bitkeeper/dddac1794build/powercontroller/README.MD

* attiny85 - software sketch for the attiny85
* design - initial design of the soft power off module
* pcb - scheme and pcb design for actual use
