bitkeeper/dddac1794build/powercontroller/design/tinkercad - pi poweroff switch.png

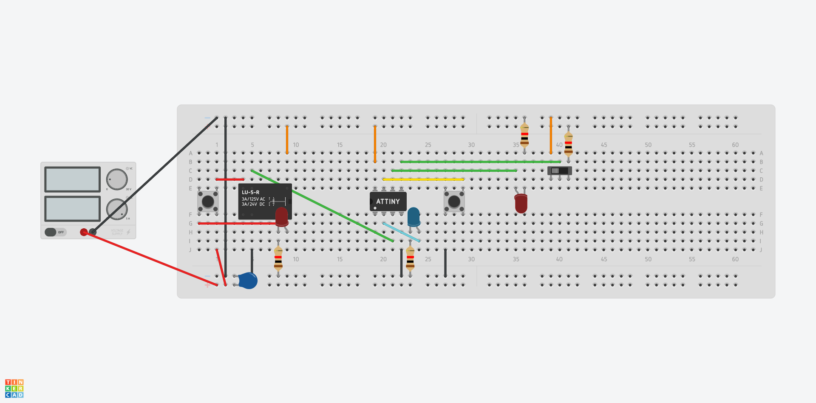
powercontroller/design/tinkercad - pi poweroff switch.png
