bitkeeper/dddac1794build/powercontroller/design/tinycad power switch.png

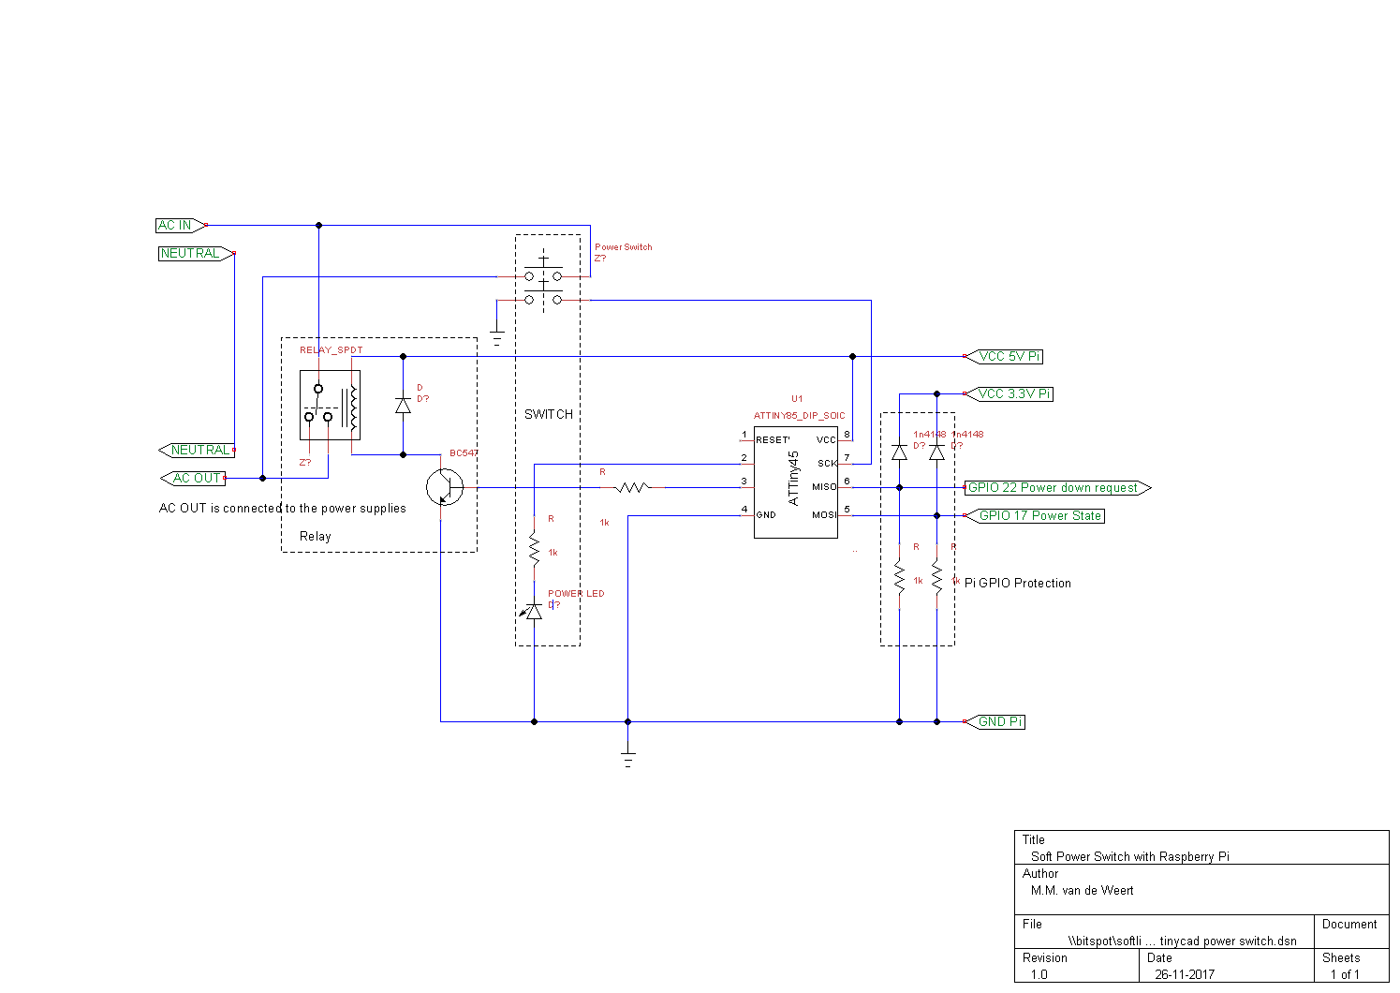
powercontroller/design/tinycad power switch.png
