bitkeeper/dddac1794build/raspberrypi/software/tweaks/moode_mpd_tweaks/moode_mpd_tweaks_config.png

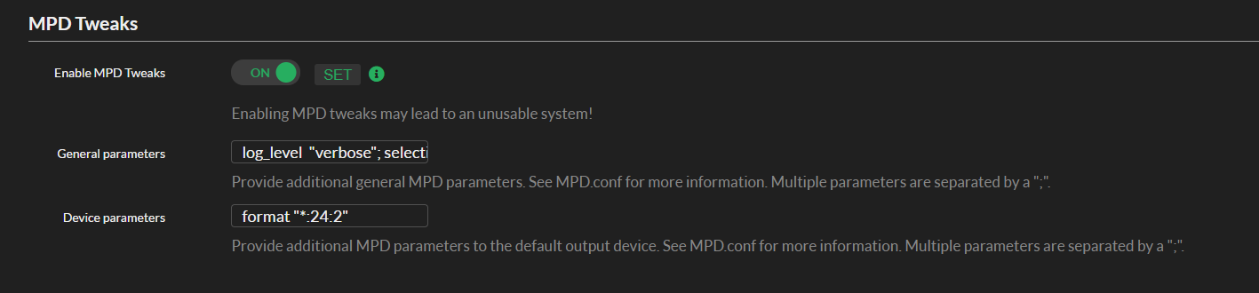
raspberrypi/software/tweaks/moode_mpd_tweaks/moode_mpd_tweaks_config.png
