bitkeeper/dddac1794build/system/partlist.ods

nr | description | subsystem | Supplier | count | price | total | Shipping
1 | DDDAC 1794 blue mainboard | dac | Audiocreative | 1 | € 165,00 | € 165,00 | € 0,00
2 | DDDAC 1794 DAC board | dac | Audiocreative | 3 | € 159,00 | € 477,00 | € 0,00
3 | DDDAC 12V PS | dac | Audiocreative | 1 | € 94,00 | € 94,00 | € 0,00
5 | DIYINHK Ultra Low Noise PS | streamer | Diyinhk | 1 | € 41,82 | € 41,82 | € 9,08
6 | Block RDK 30VA/2x6V | streamer | Conrad | 1 | € 19,64 | € 19,64 | € 0,00
7 | Raspberry 3 | streamer | SOSsolutions | 1 | € 36,95 | € 36,95 | € 0,00
8 | SD Card 8 GB | streamer | SOSsolutions | 1 | € 7,95 | € 7,95 | € 0,00
9 | Hifiberry Digi+ Pro | streamer | SOSsolutions | 0 | € 42,95 | € 0,00 | € 0,00
10 | AC Main C14 Chassis part | case | Conrad | 1 | € 5,25 | € 5,25 | € 0,00
11 | Fuse 20mm | case | Conrad | 1 | € 1,20 | € 1,20 | € 0,00
12 | Torx147 Optical SPDIF Receiver 192k | case | Diyinhk | 1 | € 3,35 | € 3,35 | € 9,08 | N.A. due combinated order
13 | CinchConnector Rean AV NYS367-9 | case | Conrad | 1 | € 4,36 | € 4,36 | € 0,00
14 | CinchConnector Rean AV NYS367-2 | case | Conrad | 1 | € 4,36 | € 4,36 | € 0,00
15 | CinchConnector Rean AV NYS367-4 | case | Conrad | 3 | € 4,36 | € 13,08 | € 0,00
16 | Cinch-connector internal | case | Conrad | 1 | € 1,48 | € 1,48 | € 0,00
17 | OLED Display 1.3" I2C | case | Diymall by ebay | 1 | € 8,51 | € 8,51 | € 0,00
18 | Galaxy Maggiorato GX388 330 x 280mm x 2HE 10mm front panel SILVER | case | Modus | 1 | € 53,00 | € 53,00 | € 13,00
19 | Base Galaxy GX345/348/385/388 | case | Modus | 1 | € 8,00 | € 8,00 | € 13,00 | N.A. due combinated order
20 | Case feets | case | Modus | 4 | € 3,50 | € 14,00 | € 13,00 | N.A. due combinated order
21 | Frontplate Job | case | Schaeffer | 1 | € 58,89 | € 58,89 | € 19,50
22 | Backplate Jobs | case | Schaeffer | 1 | € 42,38 | € 42,38 | € 19,50 | N.A. due combinated order
23 | Relais board arduino 1x relais (active high) | case | DX | 1 | € 2,30 | € 2,30 | € 0,00
24 | Relais board arduino 2x relais (active low) | case | DX | 1 | € 4,00 | € 4,00 | € 0,00
25 | Attiny85 | case | ? | 1 | € 2,30 | € 2,30 | € 2,60
26 | Switch TRU COMPONENTS LAS1-AGQ-22E, BL | case | Conrad | 2 | € 19,82 | € 39,64 | € 0,00
27 | Allo Isolator | streamer | SOSsolutions | 0 | € 60,95 | € 0,00 | € 0,00
28 | Cinemags CMLI-600/600 set | dac | Audiocreative* | 1 | € 249,00 | € 249,00 | € 0,00
29 | PiFace GPIO Shim | streamer | Kiwi Electronics | 1 | € 5,95 | € 5,95 | € 2,50
30 | FifoPi Q3 | reclocker | Audiophonics | 1 | € 159,00 | € 159,00 | € 8,50
31 | U.FL coax cable 6" | reclocker | Audiophonics | 3 | € 5,50 | € 16,50 | € 8,50 | N.A. due combinated order
32 | Custom print for power distribution | case | OSHPark | 1 | € 16,20 | € 16,20 | € 0,00
33 | Omron G3MB-202P | case |  | 1 | € 2,95 | € 2,95 | € 3,95
34 | PCB Screw Terminal | case |  | 5 | € 0,45 | € 2,25 | € 3,95 | N.A. due combinated order
 |  |  |  |  | parts | € 1560,31
 |  |  |  |  | shipping | € 59,13
 |  |  |  |  | total cost | € 1.619,44
