bitkeeper/dddac1794build/case/hifi2000_galaxy/preview/backplate.pdf

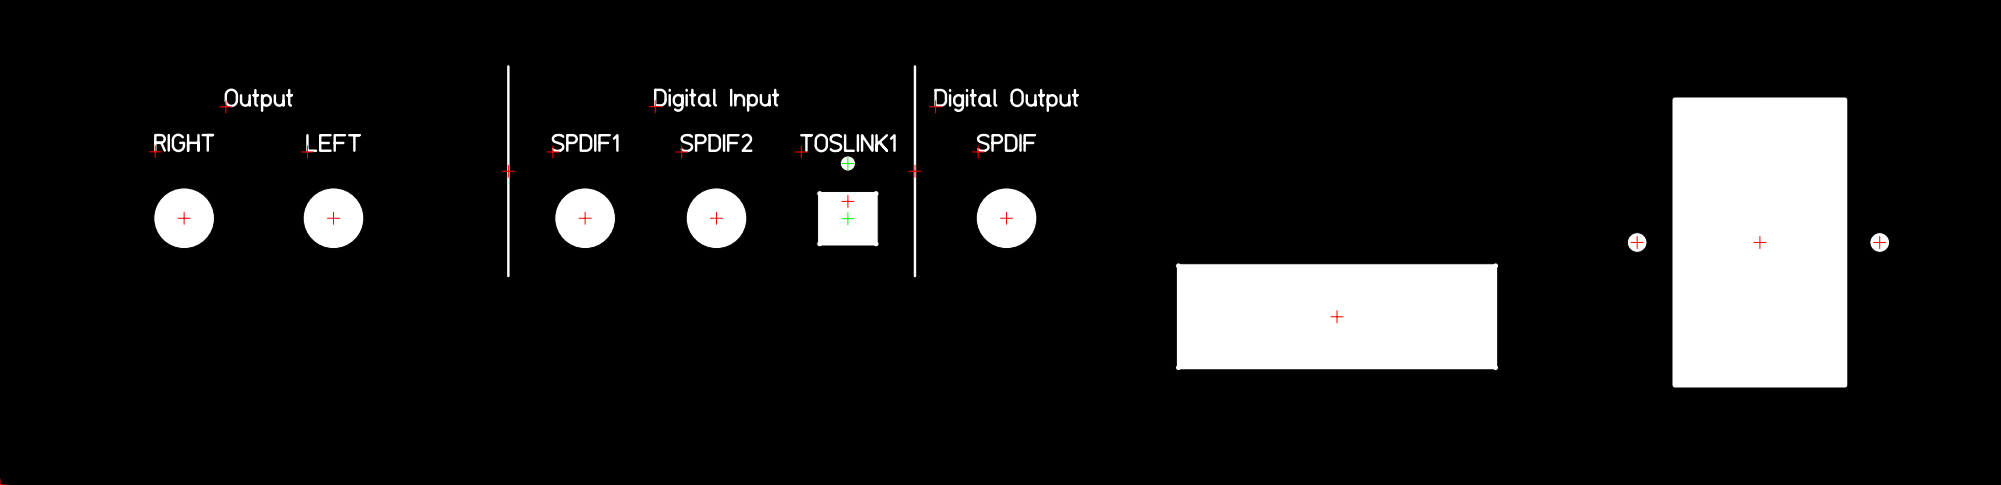
[picture p4: page 1]
