bitkeeper/dddac1794build/case/hifi2000_galaxy/preview/frontplate.pdf

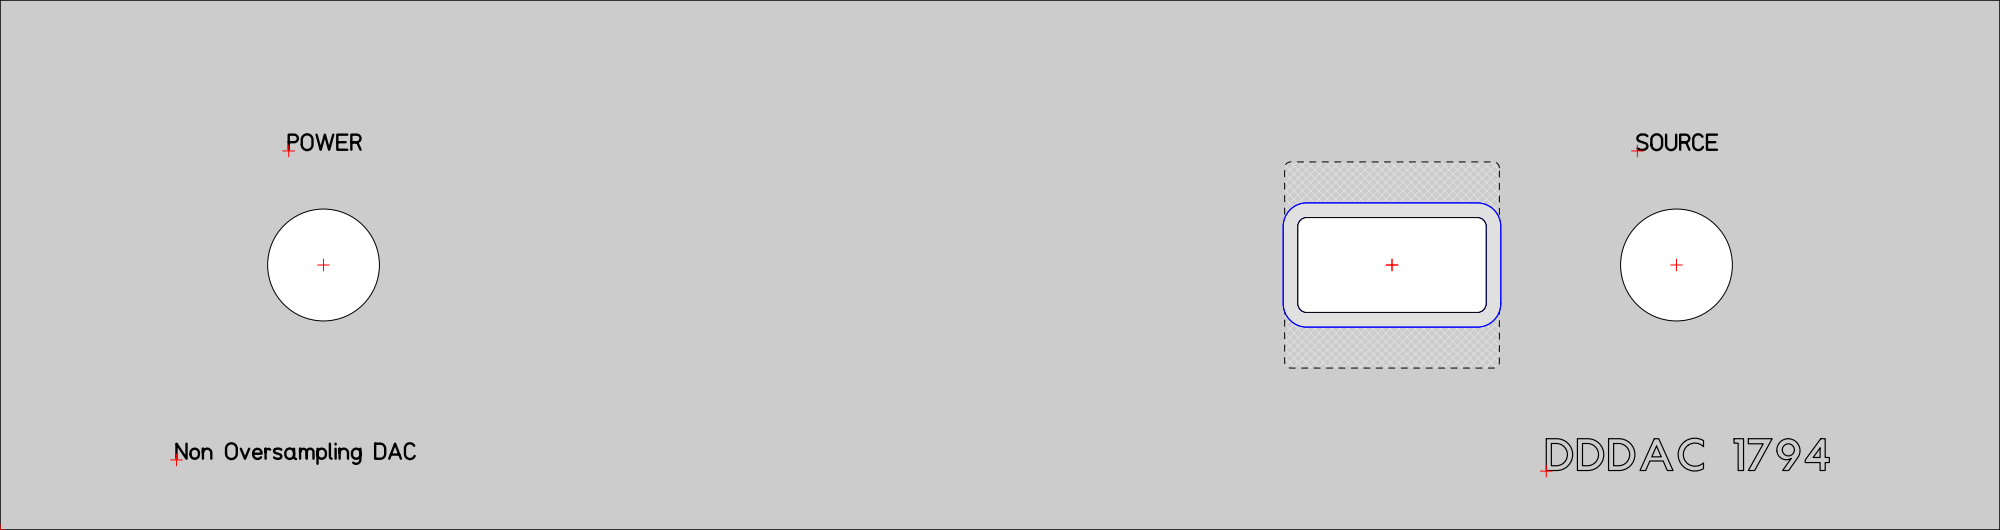
[picture p5: page 1]
