bitkeeper/dddac1794build/(list of files, drawings)

Other design files:
powercontroller/design/tinycad power switch.dsn
