bitkeeper/dddac1794build/powercontroller/pcb/softdown/softdown.kicad_pcb

## KiCad design powercontroller/pcb/softdown/softdown.kicad_pcb (2020-04-29)

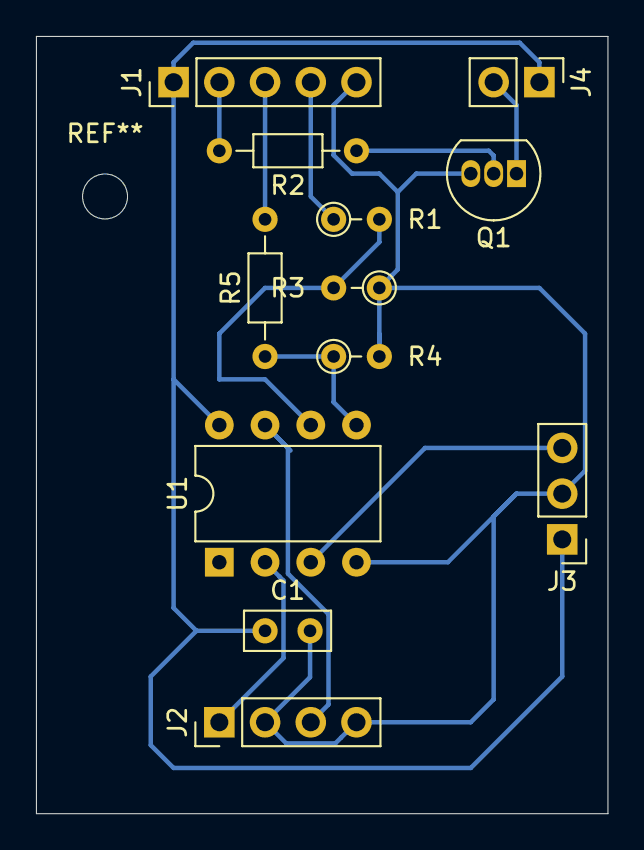
[picture p6: board softdown.kicad_pcb from above]

Board: 2 copper layers, 31.8 x 43.2 mm, 12 parts (0 on the bottom side), 12 nets.

Parts:
C1: C; C_Rect_L4.6mm_W2.0mm_P2.50mm_MKS02_FKP02
J1: RaspberryIO; PinHeader_1x05_P2.54mm_Vertical
J2: SwitchPowerAndLed; PinHeader_1x04_P2.54mm_Vertical
J3: RelayBoard; PinHeader_1x03_P2.54mm_Vertical
J4: SwitchSourceLed; PinHeader_1x02_P2.54mm_Vertical
Q1: BC547; TO-92_Inline
R1, R3, R4: 1k; R_Axial_DIN0204_L3.6mm_D1.6mm_P2.54mm_Vertical
R2: 2k7; R_Axial_DIN0204_L3.6mm_D1.6mm_P7.62mm_Horizontal
R5: 1k; R_Axial_DIN0204_L3.6mm_D1.6mm_P7.62mm_Horizontal
U1: ATtiny85-20PU; DIP-8_W7.62mm

Connections:
+5V: C1.1, J1.1, J3.1, J4.1, U1.8
GND: C1.2, J1.5, J2.2, J2.4, J3.2, Q1.3, R3.1, R4.2, U1.4
unnamed: J4.2, Q1.1
unnamed: Q1.2, R2.1
unnamed: R1.2, R3.2, U1.6
unnamed: R4.1, R5.1, U1.5
button_pin: J2.3, U1.7
led_pin: J2.1, U1.2
pi_state: J1.3, R5.2
pwr_down_req: J1.4, R1.1
relais_pin: J3.3, U1.3
source_led: J1.2, R2.2
