bitkeeper/dddac1794build/raspberrypi/software/softpowerdown/config.example.txt

dtoverlay=gpio-shutdown,gpio_pin=22,active_low=0,gpio_pull=off
#dtoverlay=gpio-poweroff,gpiopin=17,active_low
