bitkeeper/dddac1794build/(commit log)

2020-07-15 fixed stuck on Digital 1
    [mp2luma.py]
2020-09-04 Synced with current MPD PR status
2020-11-13 Replaced Hifiberry Digi+ Pro and Allo Isolator by an FifoPi
    [dddac1794nos.sch, partlist.ods]
2020-12-19 update to current used hardware configuration
2021-10-19 Fixed copy in samplerate in the 0.23 patch
    Was based on older 0.22 patch, while newer one of 0.22 already did contain that patch.
